JasonLvernex/Design-of-a-Catapulted-Self-deployable-UAV/README.md

# Design-of-a-Catapulted-Self-deployable-UAV
This is the STM32 project of the catapulted self-deployable UAV, for further reference please cite my paper, Lyu T, Qin S, Tian ZA, Zhang QY, Xu YJ, Lin KX, Design of a Catapulted Self-deployable UAV, Journal of Physics:Conference Series(ISSN: 1742-6588)
