JasonLvernex/Design-of-a-Catapulted-Self-deployable-UAV/STM32 program/USER/ALL_DEFINE.h

#ifndef __ALL_DEFINE_H__
#define __ALL_DEFINE_H__
#include "stm32f10x.h"
#include "ALL_DATA.h"
#include "INIT.h"
#include "sys.h"
#include "I2C.h"
#include "SPI.h"
#include "nrf24l01.h"
#include "USART.h"
#include  "TIM.h"
#include "LED.h"
#include "mpu6050.h"
#include "imu.h"
#include "ANO_DT.h"
#include "Remote.h"
#include "control.h"
#include "myMath.h"
#undef SUCCESS
#define SUCCESS 0
#undef FAILED
#define FAILED  1



#endif
