JasonLvernex/Design-of-a-Catapulted-Self-deployable-UAV/STM32 program/USER/delay.h

#ifndef _DELAY_H
#define _DELAY_H 


#include "stm32f10x.h"

#define	IRQ_1MS	1000
#define	IRQ_2MS	2000
#define	IRQ_3MS	3000
#define	IRQ_4MS	4000

#define	DEFAULT_PERIOD	IRQ_1MS

#define	ITS_PER_MS		1000/DEFAULT_PERIOD   // 每毫秒中断的次数


extern volatile uint32_t TIMIRQCNT;



extern void cycleCounterInit(void);
extern void delay_ms(uint16_t nms);
extern uint32_t GetSysTime_us(void); 
extern void delay_us(unsigned int i);

#endif
