JasonLvernex/Design-of-a-Catapulted-Self-deployable-UAV/(notices)

Notices in the files:
STM32 program/HARDWARE/stmflash.c:
Copyright(C) ¹ãÖÝÊÐÐÇÒíµç×Ó¿Æ¼¼ÓÐÏÞ¹«Ë¾ 2009-2019
All rights reserved
